giacomo30196/G-C_matter_controller/(commit log)

2025-12-18 0-10V IN schematic
    [0_10v_input.kicad_sch, PCB.kicad_sch]
2025-12-21 fix to 0-10V IN schematic, 0-10V OUT schematic
    [0_10v_driver.kicad_sch, 0_10v_input.kicad_sch, PCB.kicad_pcb, mcu.kicad_sch]
2025-12-21 fix to 0-10v out.... idiot me :(
    [0_10v_driver.kicad_sch]
2025-12-21 minor fix, esp32 partial schematic
    [0_10v_driver.kicad_sch, 0_10v_input.kicad_sch, PCB.kicad_pcb, PCB.kicad_sch, mcu.kicad_sch]
2025-12-26 esp32 various fix, 20to3v3 DCDC.
    [0_10v_driver.kicad_sch, 0_10v_input.kicad_sch, PCB.kicad_pcb, PCB.kicad_sch, dcdc_stage.kicad_sch, mcu.kicad_sch]
2025-12-27 stusb schematic
    [0_10v_input.kicad_sch, PCB.kicad_pcb, PCB.kicad_sch, dcdc_stage.kicad_sch, mcu.kicad_sch, usb_pd.kicad_sch]
